D-uality/FusionZero-Robocup-International/4_documents/Datasheets/PDI 6221MG 360° 20KG 360° htm_files/1e6f4d21ef166d6ba756423e17e3e07e.png

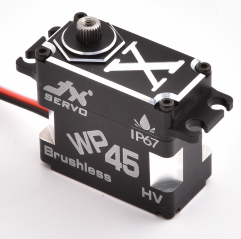
4_documents/Datasheets/PDI 6221MG 360° 20KG 360° htm_files/1e6f4d21ef166d6ba756423e17e3e07e.png
