D-uality/FusionZero-Robocup-International/4_documents/Datasheets/PDI 6221MG 360° 20KG 360° htm_files/1ec783de40fd63f22dcdefa5b233ecb2.png

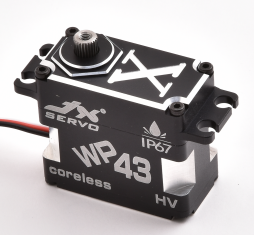
4_documents/Datasheets/PDI 6221MG 360° 20KG 360° htm_files/1ec783de40fd63f22dcdefa5b233ecb2.png
