D-uality/FusionZero-Robocup-International/4_documents/Datasheets/PDI 6221MG 360° 20KG 360° htm_files/089fc90d06dda99a380c83b12112168d.jpg

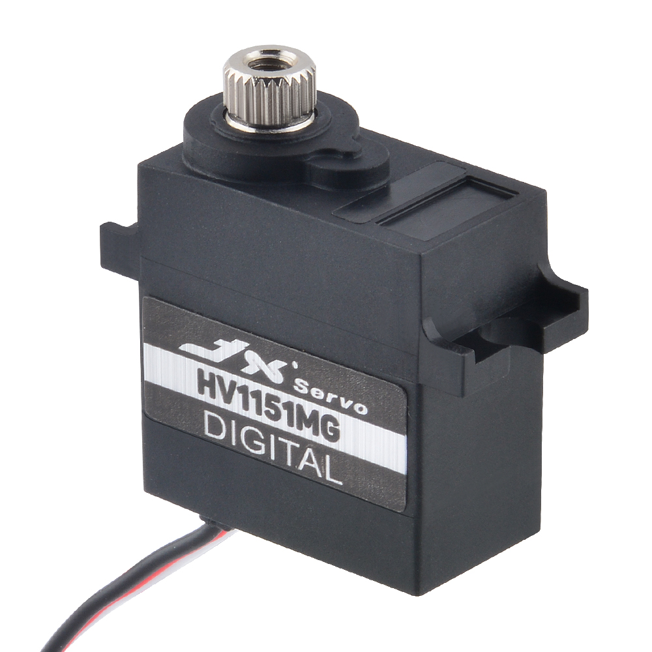
4_documents/Datasheets/PDI 6221MG 360° 20KG 360° htm_files/089fc90d06dda99a380c83b12112168d.jpg
