D-uality/FusionZero-Robocup-International/4_documents/Datasheets/PDI 6221MG 360° 20KG 360° htm_files/20177516175.png

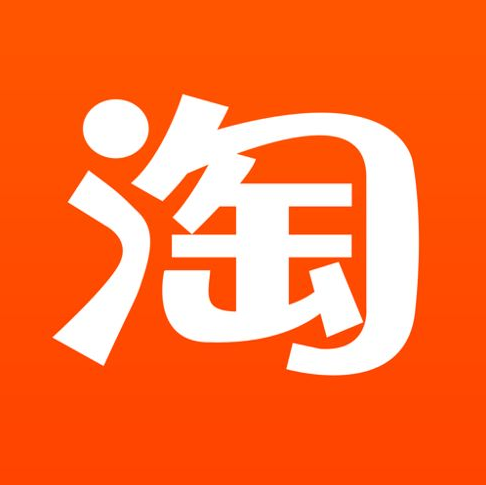
4_documents/Datasheets/PDI 6221MG 360° 20KG 360° htm_files/20177516175.png
