D-uality/FusionZero-Robocup-International/3_designs/back_base/Battery Base.step

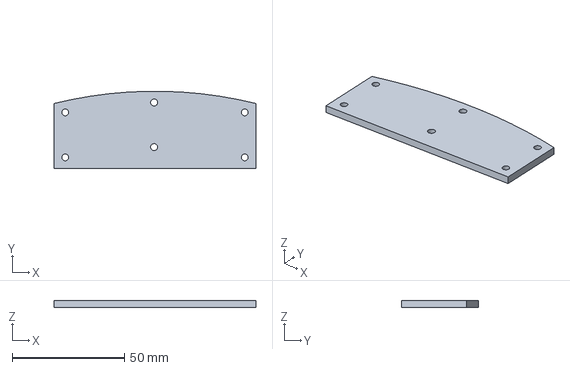
[picture p13: CAD file, 2025-03-10]
3_designs/back_base/Battery Base.step
89.8 x 34.4 x 3.00 mm
