D-uality/FusionZero-Robocup-International/3_designs/bottom_base/Bottom Base.step

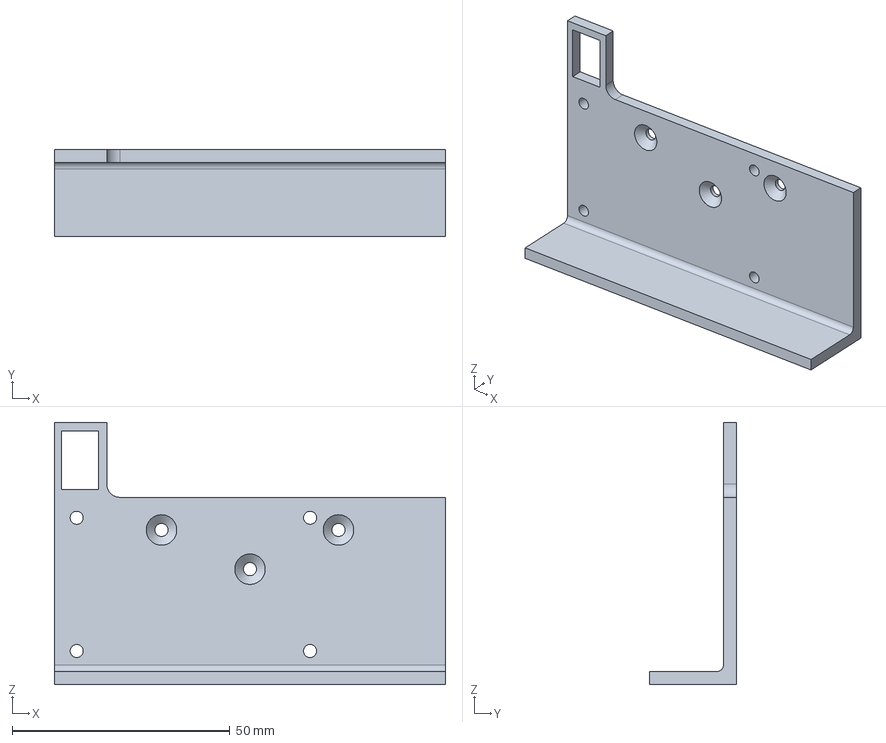
[picture p14: CAD file, 2025-03-10]
3_designs/bottom_base/Bottom Base.step
89.8 x 20.0 x 60.2 mm
