D-uality/FusionZero-Robocup-International/3_designs/components/TOF400C.step

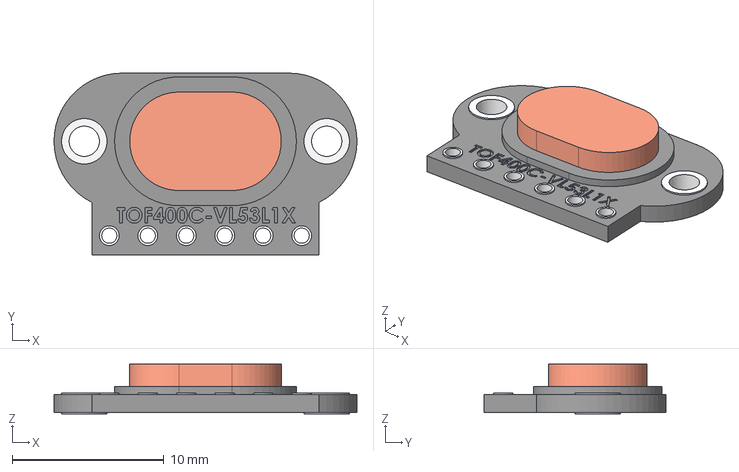
[picture p15: CAD file, 2025-03-10]
3_designs/components/TOF400C.step
20.0 x 12.0 x 3.30 mm
