D-uality/FusionZero-Robocup-International/3_designs/front_base/claw/Claw - [R] Support.step

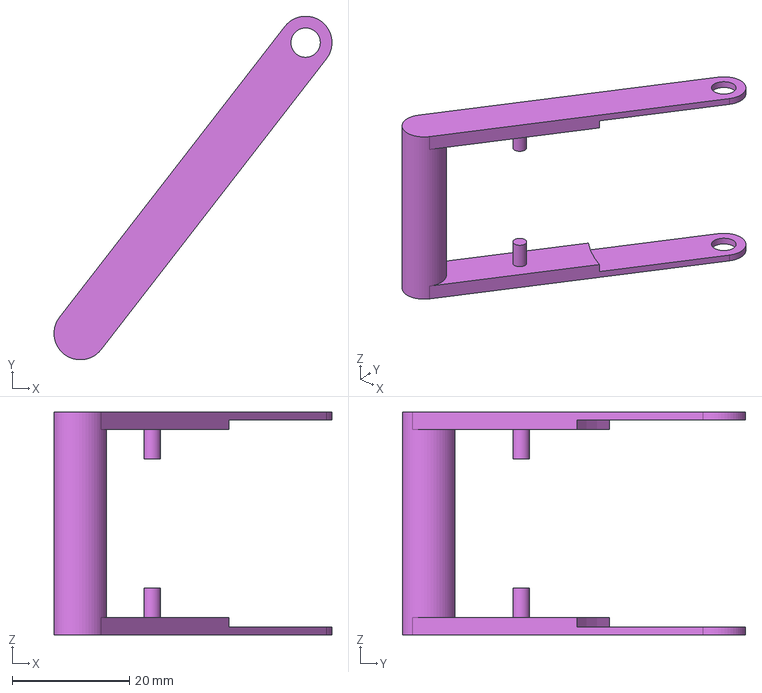
[picture p16: CAD file, 2025-03-10]
3_designs/front_base/claw/Claw - [R] Support.step
47.4 x 58.5 x 38.0 mm
