D-uality/FusionZero-Robocup-International/3_designs/front_base/Front Base.step

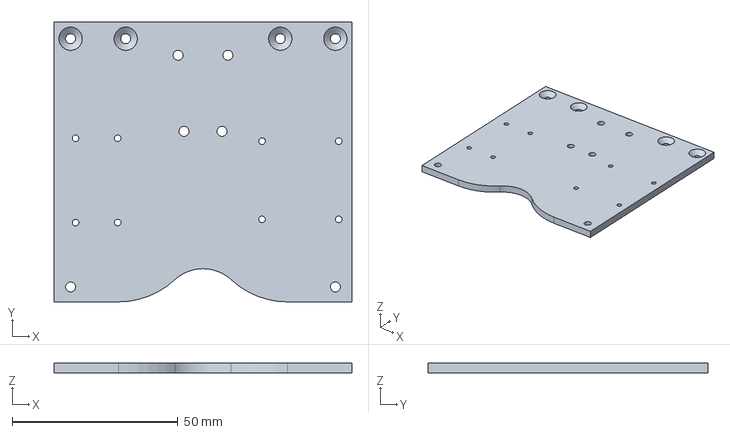
[picture p17: CAD file, 2025-03-10]
3_designs/front_base/Front Base.step
89.8 x 84.3 x 3.00 mm
