D-uality/FusionZero-Robocup-International/3_designs/front_base/lower_parts_frame/Front Touch Plate.step

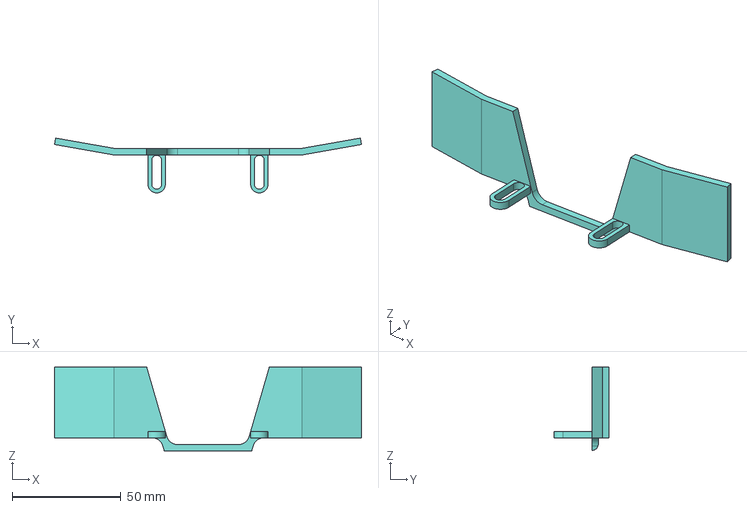
[picture p18: CAD file, 2025-03-10]
3_designs/front_base/lower_parts_frame/Front Touch Plate.step
140.8 x 25.2 x 38.3 mm
