D-uality/FusionZero-Robocup-International/3_designs/handle/Handle.step

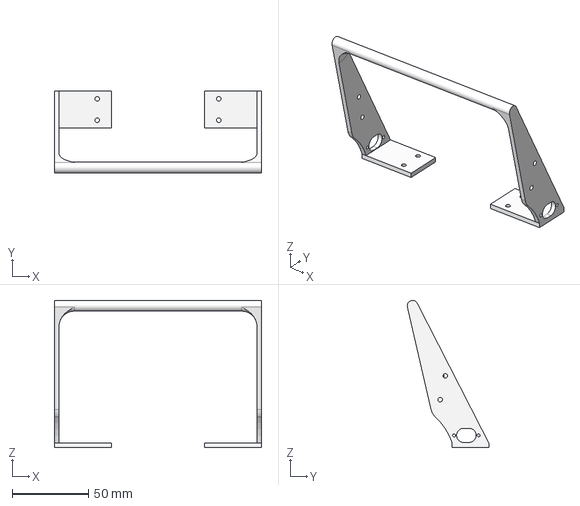
[picture p19: CAD file, 2025-03-10]
3_designs/handle/Handle.step
135.8 x 53.5 x 96.5 mm
