D-uality/FusionZero-Robocup-International/3_designs/handle/tilt_holder/Tilt Holder.step

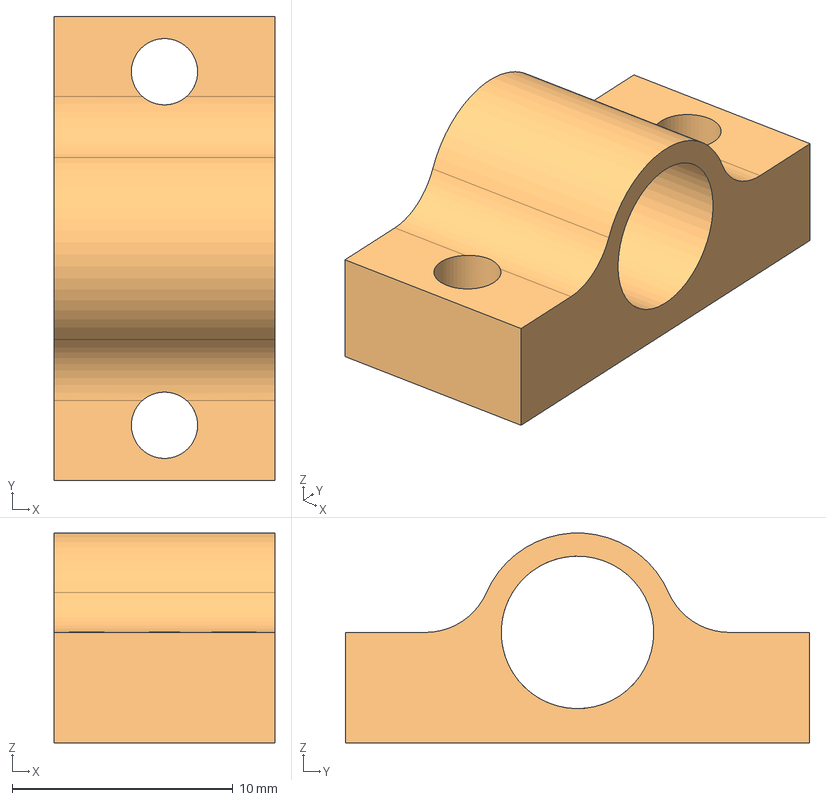
[picture p20: CAD file, 2025-03-10]
3_designs/handle/tilt_holder/Tilt Holder.step
10.0 x 21.0 x 9.49 mm
