D-uality/FusionZero-Robocup-International/3_designs/ir_sensors/IR Sensor Frame.step

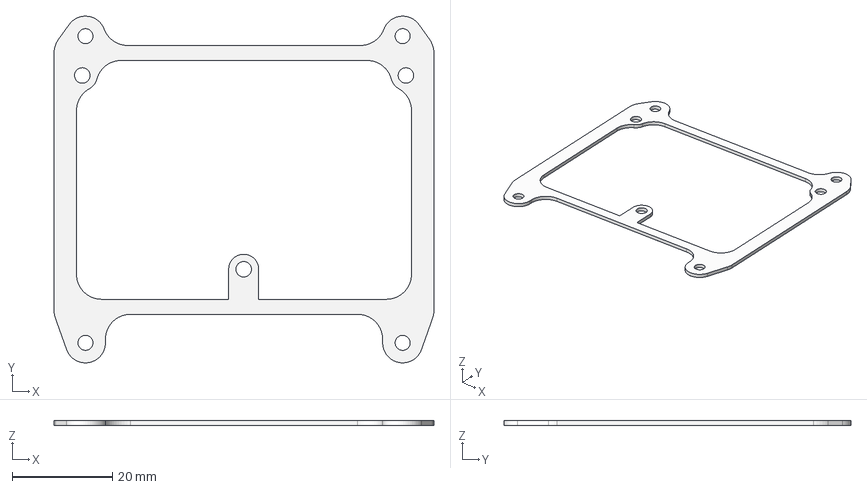
[picture p21: CAD file, 2025-03-10]
3_designs/ir_sensors/IR Sensor Frame.step
76.0 x 69.3 x 1 mm
