D-uality/FusionZero-Robocup-International/3_designs/servos/Servo Base.step

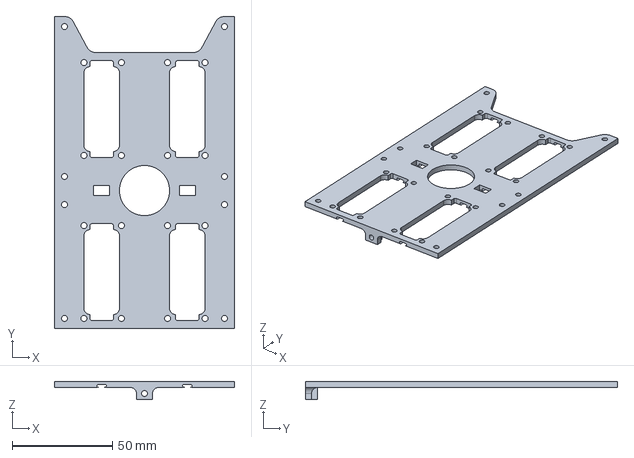
[picture p22: CAD file, 2025-03-10]
3_designs/servos/Servo Base.step
89.8 x 155.6 x 9.00 mm
