D-uality/FusionZero-Robocup-International/3_designs/back_base/Back Base.step

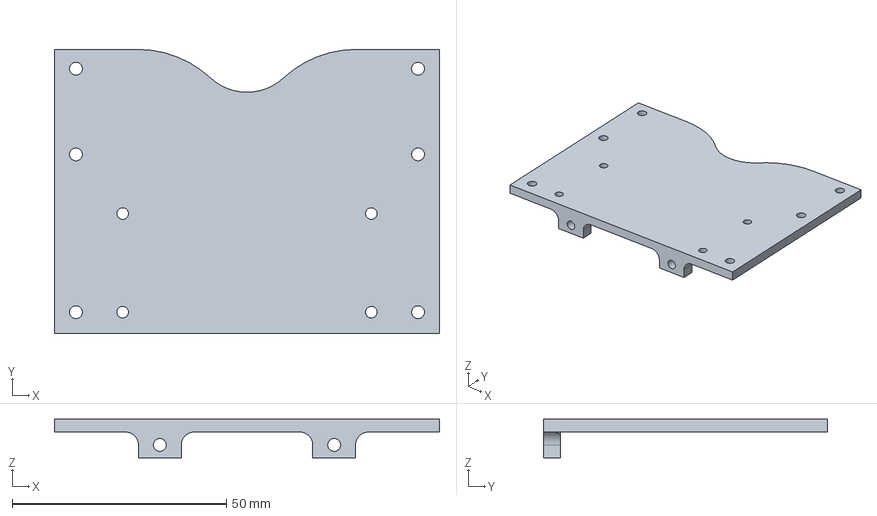
[picture p23: CAD file, 2025-03-10]
3_designs/back_base/Back Base.step
89.8 x 66.3 x 9.00 mm
