D-uality/FusionZero-Robocup-International/3_designs/components/Back Wheg - Back Wheg.step

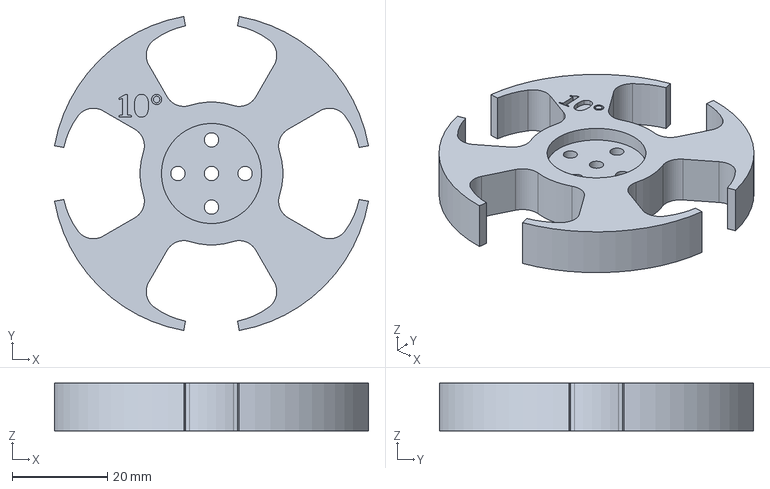
[picture p24: CAD file, 2025-03-10]
3_designs/components/Back Wheg - Back Wheg.step
65.9 x 65.9 x 10.0 mm
