D-uality/FusionZero-Robocup-International/3_designs/front_base/BNOO8X Frame.step

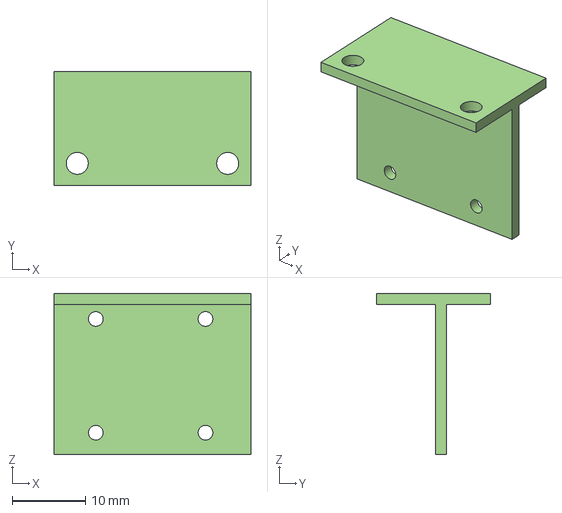
[picture p25: CAD file, 2025-03-10]
3_designs/front_base/BNOO8X Frame.step
26.8 x 15.5 x 22.0 mm
