D-uality/FusionZero-Robocup-International/3_designs/front_base/claw/Claw - Spiral Bevel 1M 15T 32deg.step

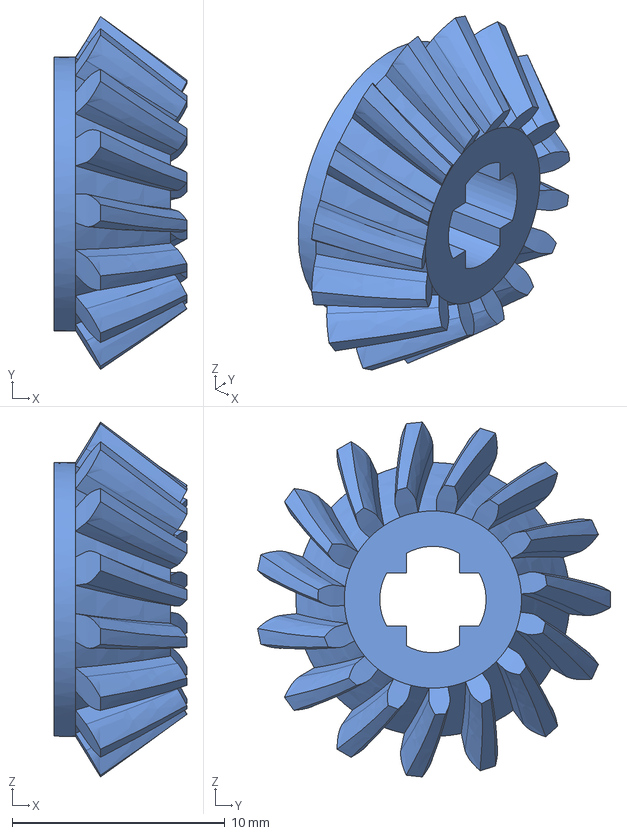
[picture p26: CAD file, 2025-03-10]
3_designs/front_base/claw/Claw - Spiral Bevel 1M 15T 32deg.step
6.23 x 16.6 x 16.7 mm
