D-uality/FusionZero-Robocup-International/3_designs/front_base/lower_parts_frame/Lower Parts Frame.step

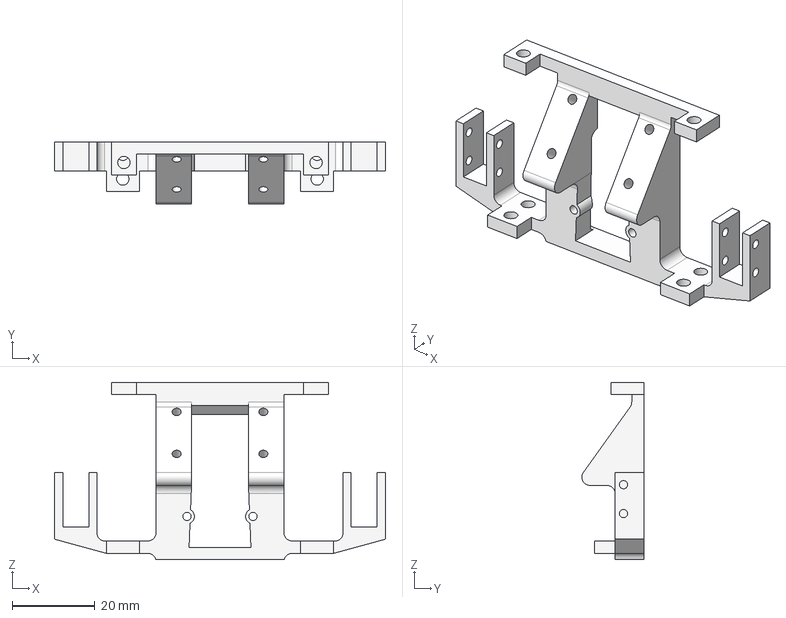
[picture p27: CAD file, 2025-03-10]
3_designs/front_base/lower_parts_frame/Lower Parts Frame.step
80.2 x 15.1 x 43.0 mm
