D-uality/FusionZero-Robocup-International/3_designs/servos/Servo Frame.step

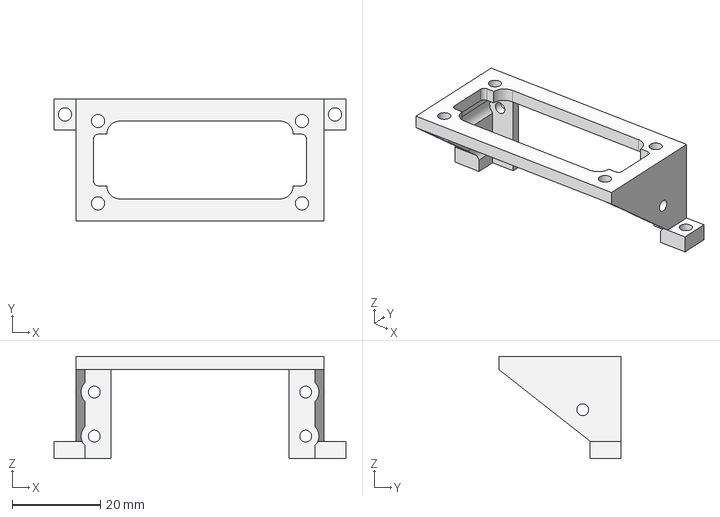
[picture p28: CAD file, 2025-03-10]
3_designs/servos/Servo Frame.step
66.3 x 27.7 x 23.2 mm
