D-uality/FusionZero-Robocup-International/3_designs/components/OLED 128x64 0.96.step

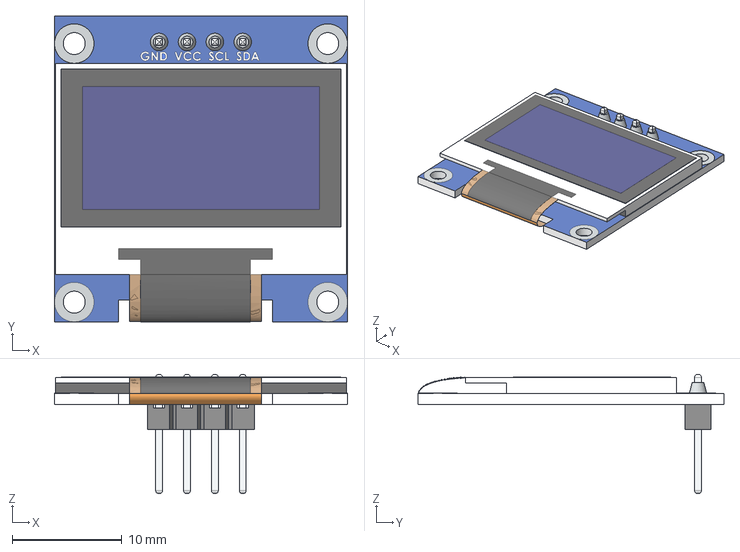
[picture p29: CAD file, 2025-03-10]
3_designs/components/OLED 128x64 0.96.step
26.7 x 27.9 x 10.8 mm
