D-uality/FusionZero-Robocup-International/3_designs/front_base/claw/Claw - [R] Claw.step

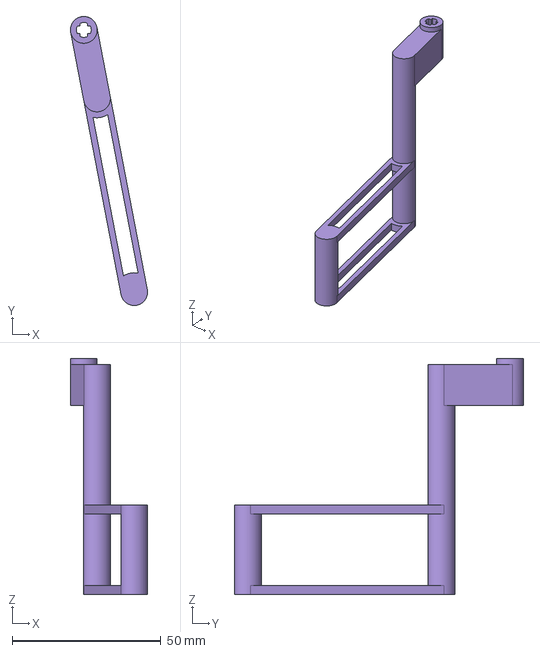
[picture p30: CAD file, 2025-03-10]
3_designs/front_base/claw/Claw - [R] Claw.step
25.9 x 97.0 x 79.3 mm
