D-uality/FusionZero-Robocup-International/3_designs/components/PDI_6221MG.STEP

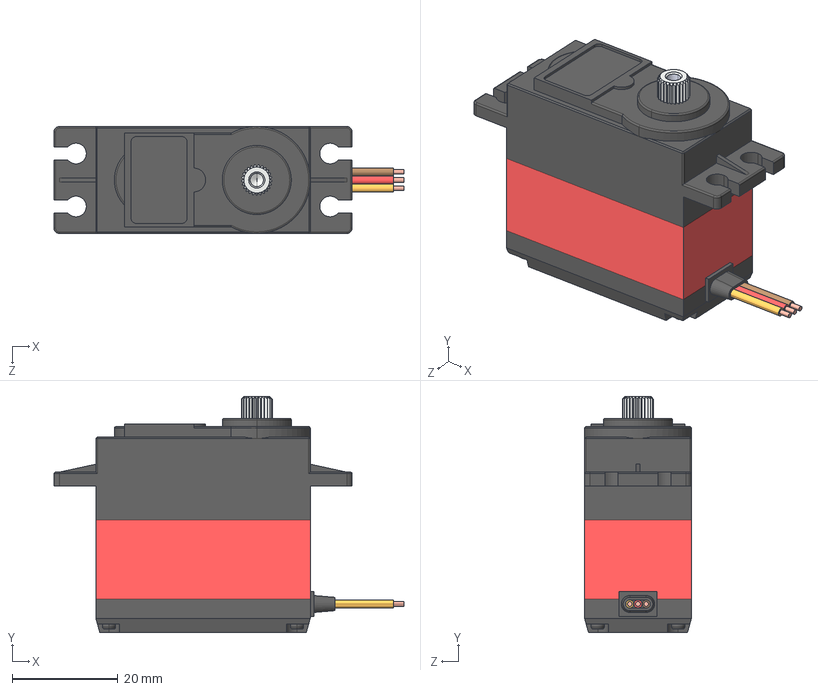
[picture p32: CAD file, 2025-03-10]
3_designs/components/PDI_6221MG.STEP
66.1 x 44.6 x 20.2 mm
