D-uality/FusionZero-Robocup-International/3_designs/components/Rocker Switch.stp

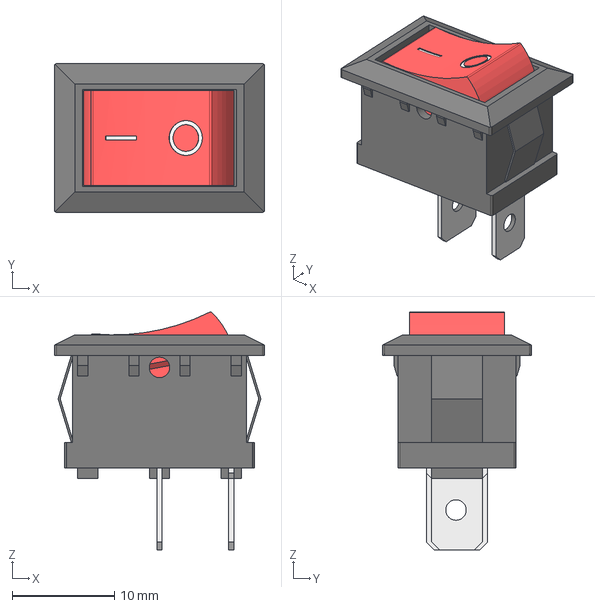
[picture p33: CAD file, 2025-03-10]
3_designs/components/Rocker Switch.stp
20.5 x 14.5 x 23.2 mm
