D-uality/FusionZero-Robocup-International/3_designs/front_base/claw/Claw - Spiral Bevel 1M 24T 58deg.step

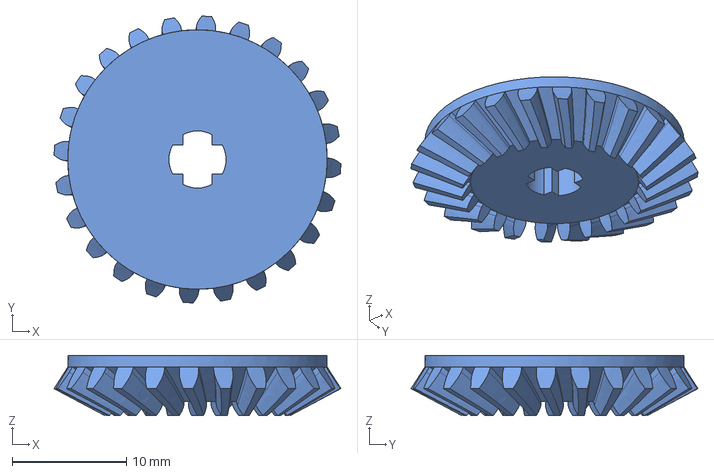
[picture p34: CAD file, 2025-03-10]
3_designs/front_base/claw/Claw - Spiral Bevel 1M 24T 58deg.step
25.1 x 25.1 x 5.26 mm
