D-uality/FusionZero-Robocup-International/3_designs/components/Rasbperry Pi Camera Module 3.step

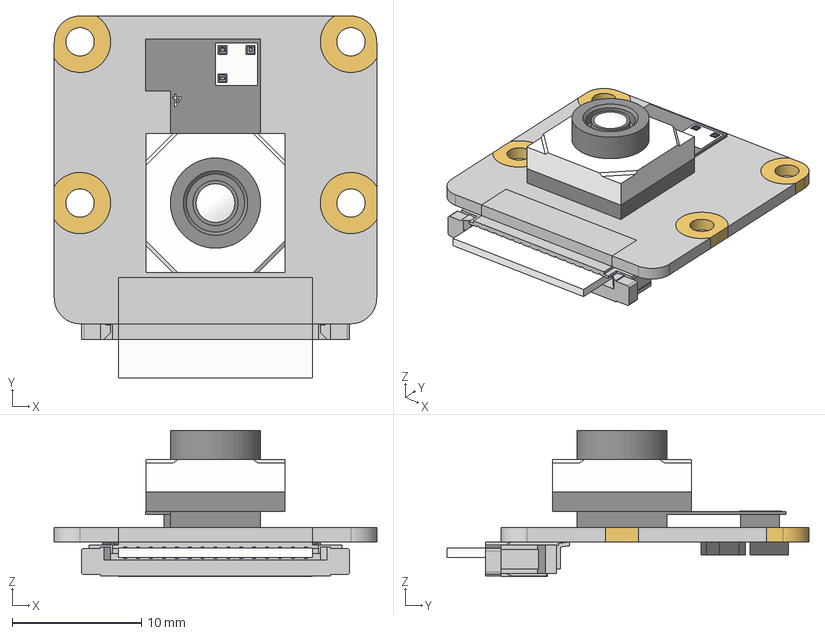
[picture p35: CAD file, 2025-03-10]
3_designs/components/Rasbperry Pi Camera Module 3.step
25.0 x 28.1 x 11.3 mm
Board
sfw15r3ste1lf
Sensor
Lens
Ring
Mount
Housing
