D-uality/FusionZero-Robocup-International/3_designs/components/Front Wheg - Front Wheg.step

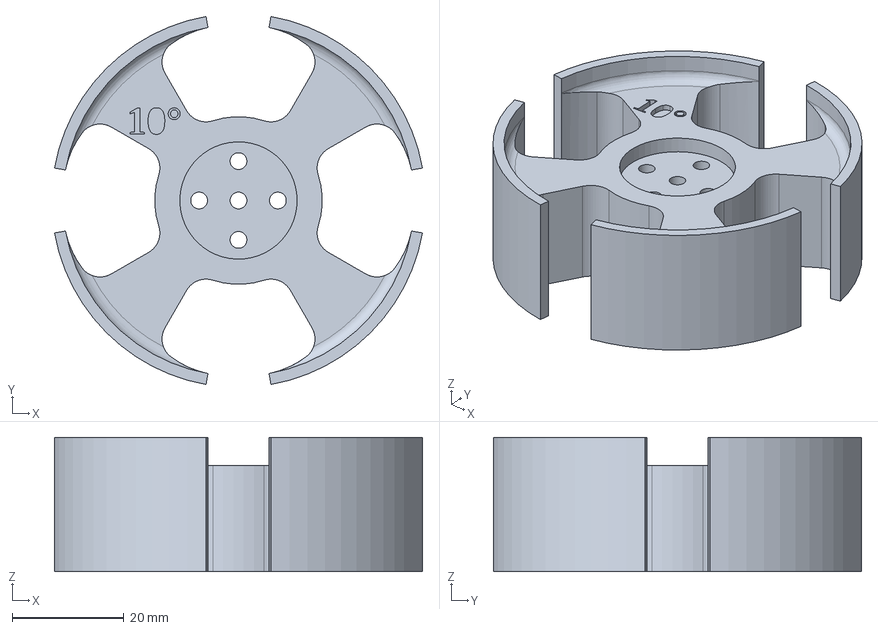
[picture p36: CAD file, 2025-03-10]
3_designs/components/Front Wheg - Front Wheg.step
65.9 x 65.9 x 24.0 mm
