D-uality/FusionZero-Robocup-International/3_designs/components/2 x 18650 Battery Holder.stp

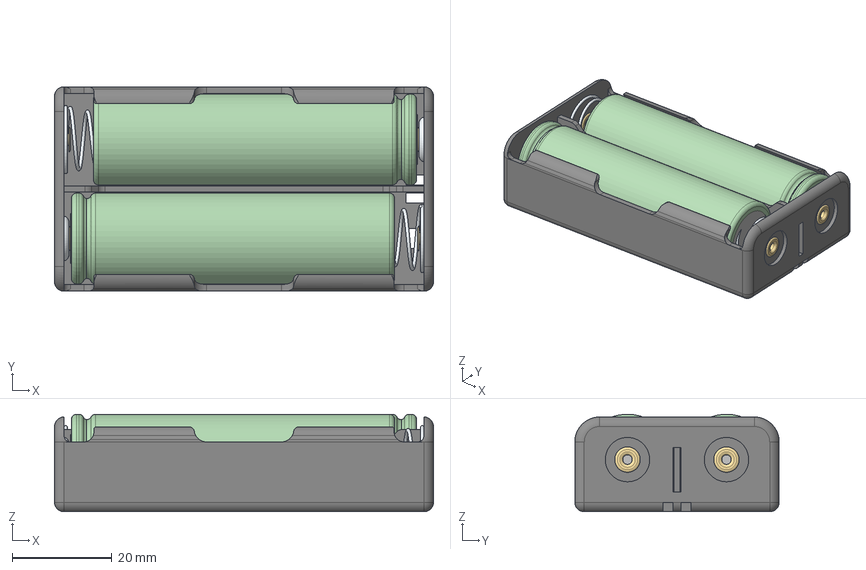
[picture p37: CAD file, 2025-03-10]
3_designs/components/2 x 18650 Battery Holder.stp
76.0 x 41.0 x 19.5 mm
Porta baterias 2x18650
Contacto_Helice_v2.0 x 2
Contacto_plano_v1.0 x 2
Bateria 18650 x 2
remache_v1.0 x 4
