D-uality/FusionZero-Robocup-International/3_designs/front_base/claw/Claw - Rotating Frame.step

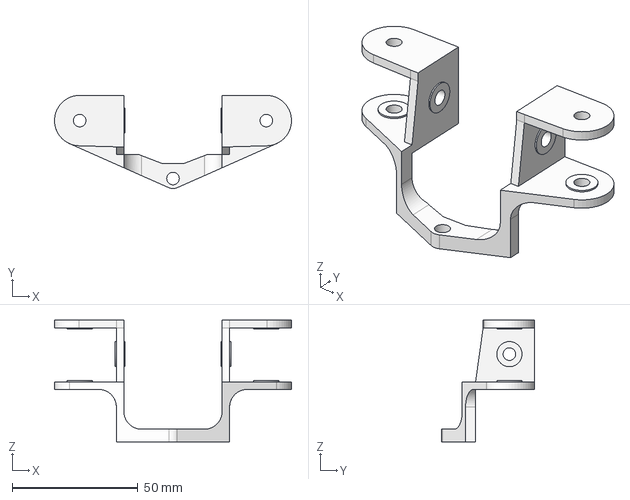
[picture p38: CAD file, 2025-03-10]
3_designs/front_base/claw/Claw - Rotating Frame.step
94.1 x 37.0 x 48.3 mm
