D-uality/FusionZero-Robocup-International/3_designs/components/Claw Servo.step

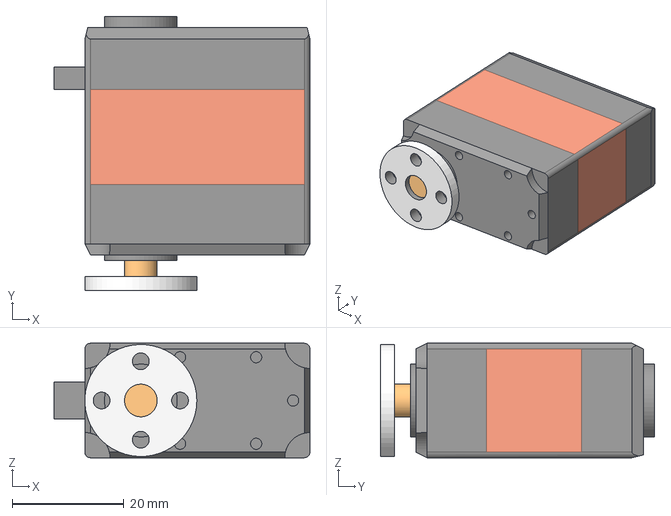
[picture p39: CAD file, 2025-03-10]
3_designs/components/Claw Servo.step
45.7 x 48.9 x 20.4 mm
