D-uality/FusionZero-Robocup-International/3_designs/front_base/claw/Claw - Drive Servo Frame.step

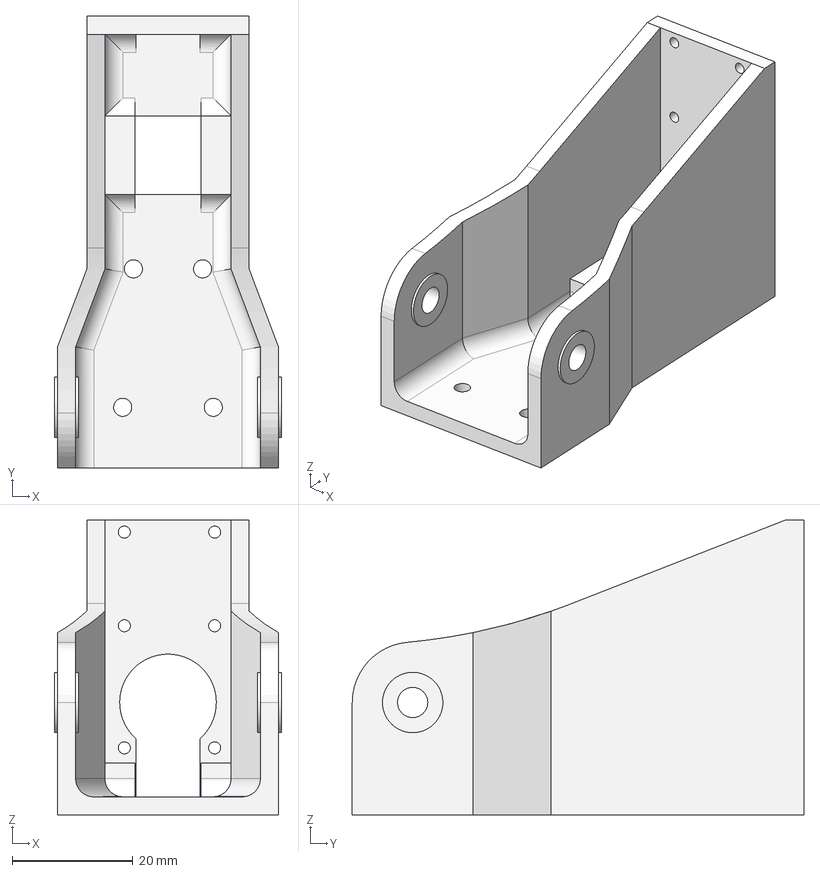
[picture p40: CAD file, 2025-03-10]
3_designs/front_base/claw/Claw - Drive Servo Frame.step
37.6 x 74.7 x 48.8 mm
