D-uality/FusionZero-Robocup-International/3_designs/components/Touch Sensor v1.step

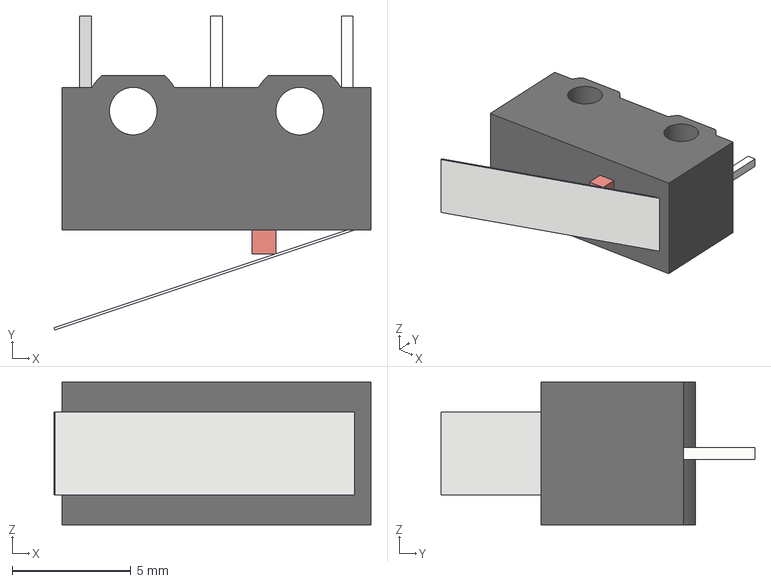
[picture p41: CAD file, 2025-03-10]
3_designs/components/Touch Sensor v1.step
13.3 x 13.2 x 6.00 mm
