D-uality/FusionZero-Robocup-International/3_designs/front_base/claw/Claw - Spiral Bevel 1M 25T 45deg.step

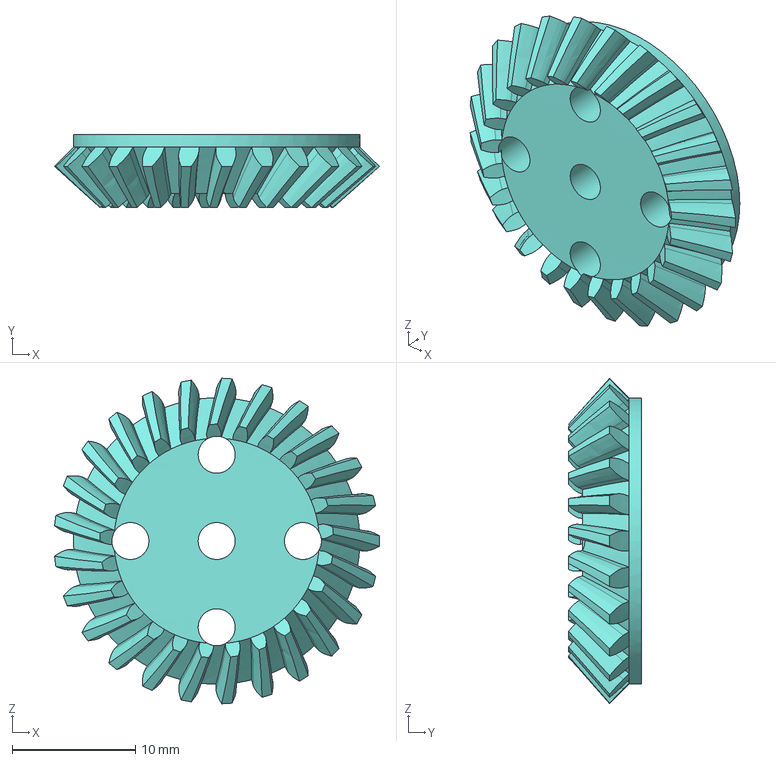
[picture p42: CAD file, 2025-03-10]
3_designs/front_base/claw/Claw - Spiral Bevel 1M 25T 45deg.step
26.4 x 5.92 x 26.4 mm
