D-uality/FusionZero-Robocup-International/(list of files, cad)

Other CAD files:
3_designs/front_base/claw/Claw - [L] Claw.step
3_designs/front_base/claw/Claw - [L] Support.step
3_designs/front_base/claw/Claw - Spiral Bevel 1M 15T 32deg (1).step
3_designs/front_base/claw/Claw - Spiral Bevel 1M 24T 58deg (1).step
3_designs/front_base/claw/Claw - Spiral Bevel 1M 25T 45deg (1).step
3_designs/front_base/claw/Claw - Spiral Bevel 1M 25T 45deg (2).step
