D-uality/FusionZero-Robocup-International/2_pre_internatinal/calibration/calibration_values.txt

7.10 9.03 13.09 22.48 63.92 -56.28 -21.35 -12.75 -8.91 -6.70 
6.20 7.94 10.47 16.92 40.13 -55.05 -19.02 -11.42 -8.26 -6.29 
5.09 6.59 9.15 15.34 50.86 -47.73 -15.12 -9.03 -8.37 -6.10 
5.44 6.79 9.61 15.71 44.90 -50.69 -16.37 -9.78 -7.00 -5.43
