D-uality/FusionZero-Robocup-International/2_pre_internatinal/calibration/frederick_calibration_values.txt

4.68 6.06 8.71 15.39 64.80 40.01 12.82 7.54 5.55 4.59
4.97 5.86 8.33 14.46 47.65 67.51 14.04 8.03 5.51 4.56
4.91 5.96 8.39 14.33 47.99 39.45 13.11 8.05 5.84 4.89
4.88 5.77 8.28 14.11 46.50 45.11 13.10 7.96 5.76 4.85
