D-uality/FusionZero-Robocup-International/2_pre_internatinal/pre_international/evacuation_zone/calibration_values.txt

23,25,35,27,23,119,115
163,164,163,181,185,206,214
