D-uality/FusionZero-Robocup-International/2_pre_internatinal/pre_international/line_follow/colour_line_following/calibration_values.txt

44,44,72,55,58,167,154
207,208,221,148,196,227,226
