D-uality/FusionZero-Robocup-International/2_pre_internatinal/pre_international/competition_mode/robocup_japan_open/modules/calibration_values.txt

39,42,40,39,29,102,89
167,163,153,151,150,190,181
