D-uality/FusionZero-Robocup-International/2_pre_internatinal/pre_international/competition_mode/robocup_singapore_open/modules/calibration_values.txt

25,27,25,19,17,98,78
184,178,168,166,164,193,177
