D-uality/FusionZero-Robocup-International/2_pre_internatinal/pre_international/line_follow/sensor_fusion_line_following/2_gyro_integration/modules/calibration_values.txt

27,31,35,24,16,89,67
187,182,177,167,164,171,156
