D-uality/FusionZero-Robocup-International/2_pre_internatinal/pre_international/line_follow/sensor_fusion_line_following/1_line_follow_testing/modules/calibration_values.txt

45,54,0,50,36,143,143
196,192,196,213,208,211,219
