D-uality/FusionZero-Robocup-International/2_pre_internatinal/pre_international/evacuation_zone/4_exit/config.py

WIDTH, HEIGHT, FLIP = 320, 240, False
SCREEN_WIDTH, SCREEN_HEIGHT = 128, 64
X11 = True

touch_pins = [5, 6, 22, 26]  # FL, FR, BL, BR
x_shut_pins = [23, 24, 25]  # Left, Middle, Right

stop_angles = [88, 89, 88, 89]
servo_pins = [14, 13, 12, 10]  # FL, FR, BL, BR
claw_pin = 9

# ------------------------------------------

status_messages = []

victim_count = 2
evacuation_speed = 35
approach_distance = 18

def update_log(data: list[str], coloumn_widths: list[int], separator: str = "|") -> str:
    formatted_cells = [f"{cell:^{width}}" for cell, width in zip(data, coloumn_widths)]
    return f" {separator} ".join(formatted_cells)
