D-uality/FusionZero-Robocup-International/2_pre_internatinal/pre_international/evacuation_zone/2_spectral_highlight/motors.py

from config import *
import time
from adafruit_servokit import ServoKit
import operator

pca = ServoKit(channels=16)
pca.servo[claw_pin].actuation_range = 270

def initialise():
    try:
        pca.servo[servo_pins[0]].angle = stop_angles[0]
        pca.servo[servo_pins[1]].angle = stop_angles[1]
        pca.servo[servo_pins[2]].angle = stop_angles[2]
        pca.servo[servo_pins[3]].angle = stop_angles[3]

        pca.servo[claw_pin].angle = 270
    except Exception as e:
        print(f"Failed to initialise motors: {e}")

def run(v1, v2, delay=0):

    calculatedAngles = [0, 0, 0, 0]

    negativeGradients  = [0.69106, 0.73440, 0.68426, 0.67425]
    negativeIntercepts = [-6.8834, -4.9707, -5.0095, -4.9465]
    positiveGradients  = [0.69924, 0.66035, 0.69858, 0.67916]
    positiveIntercepts = [4.1509, 6.5548, 3.5948, 4.2287]
    
    for i in range(0, 2):
        if   (v1 < negativeIntercepts[i]): calculatedAngles[i] = negativeGradients[i] * v1 + negativeIntercepts[i];
        elif (v1 > positiveIntercepts[i]): calculatedAngles[i] = positiveGradients[i] * v1 + positiveIntercepts[i];
        else:                              calculatedAngles[i] = 0;

        calculatedAngles[i] = max(min(calculatedAngles[i], 90), -90)

    v2 = v2 * -1

    for i in range(2, 4):
        if   (v2 < negativeIntercepts[i]): calculatedAngles[i] = negativeGradients[i] * v2 + negativeIntercepts[i];
        elif (v2 > positiveIntercepts[i]): calculatedAngles[i] = positiveGradients[i] * v2 + positiveIntercepts[i];
        else:                              calculatedAngles[i] = 0;

        calculatedAngles[i] = max(min(calculatedAngles[i], 90), -90)

    pca.servo[servo_pins[0]].angle = stop_angles[0] + calculatedAngles[0]
    pca.servo[servo_pins[1]].angle = stop_angles[1] + calculatedAngles[1]
    pca.servo[servo_pins[2]].angle = stop_angles[2] + calculatedAngles[2]
    pca.servo[servo_pins[3]].angle = stop_angles[3] + calculatedAngles[3]

    if delay > 0:
        time.sleep(delay)

        pca.servo[servo_pins[0]].angle = stop_angles[0]
        pca.servo[servo_pins[1]].angle = stop_angles[1]
        pca.servo[servo_pins[2]].angle = stop_angles[2]
        pca.servo[servo_pins[3]].angle = stop_angles[3]

def run_until(v1, v2, trigger_function, index, comparison, target_value, text=""):
    if   comparison == "==": comparison_function = operator.eq
    elif comparison == "<=": comparison_function = operator.le
    elif comparison == ">=": comparison_function = operator.ge
    elif comparison == "!=": comparison_function = operator.ne

    value = trigger_function()[index]
    while not comparison_function(value, target_value) and value is not None:
        value = trigger_function()[index]
        run(v1, v2)
        print(f"({text})")

    run(0, 0)

def claw_step(target_angle, time_delay):
    if target_angle == 270: target_angle = 269
    if target_angle == 0:   target_angle = 1
    current_angle = pca.servo[claw_pin].angle
    
    if current_angle == target_angle:
        return
    
    elif current_angle > target_angle:
        while current_angle > target_angle:
            current_angle -= 1
            pca.servo[claw_pin].angle = current_angle
            time.sleep(time_delay)
    
    else:
        while current_angle < target_angle:
            current_angle += 1
            pca.servo[claw_pin].angle = current_angle
            time.sleep(time_delay)
