D-uality/FusionZero-Robocup-International/2_pre_internatinal/pre_international/evacuation_zone/2_spectral_highlight/config.py

WIDTH, HEIGHT, FLIP = 320, 240, False
SCREEN_WIDTH, SCREEN_HEIGHT = 128, 64
X11 = True

touch_pins  = [6, 5, 22, 26]
x_shut_pins = [24, 25, 12]

stop_angles = [89, 88, 89, 88]
servo_pins = [14, 13, 12, 10]
claw_pin = 9
