D-uality/FusionZero-Robocup-International/6_technical_challenege/behaviours/robot_state.py

class RobotState():
    def __init__(self):
        # Constants
        self.debug = True
        self.timings = False

        # Variables
        self.debug_text = []
        self.oled_put_text = None
        
        self.count = {
            "uphill": 0,
            "downhill": 0,
            "tilt_left": 0,
            "tilt_right": 0,
            "red": 0,
            "silver": 0,
            "touch": 0
        }
         
        self.trigger = {
            "uphill": False,
            "downhill": False,
            "tilt_left": False,
            "tilt_right": False,
            "seasaw": False,
            "evacuation_zone": False
        }
        
        self.last_downhill = self.last_uphill = 10000
        self.last_seen_silver = self.silver_count = self.main_loop_count = 0
        self.time_since_downhill = 0
        self.prev_downhill = False
        self.first_red = False
        self.red_timer = 0
        # self.blank_for_next_red = False
        
    def reset(self):
        # Constants
        self.debug = True
        self.timings = False

        # Variables
        self.debug_text = []
        self.oled_put_text = None
        
        self.count = {
            "uphill": 0,
            "downhill": 0,
            "tilt_left": 0,
            "tilt_right": 0,
            "red": 0,
            "silver": 0,
            "touch": 0
        }
        
        self.trigger["uphill"] = False
        self.trigger["downhill"] = False
        self.trigger["tilt_left"] = False
        self.trigger["tilt_right"] = False
        self.trigger["seasaw"] = False
        
        self.last_downhill = self.last_uphill = 10000
        self.last_seen_silver = self.silver_count = self.main_loop_count = 0
        self.time_since_downhill = 0
        self.prev_downhill = False
        self.first_red = False
        self.red_timer = 0
        # self.blank_for_next_red = False
        
