D-uality/FusionZero-Robocup-International/2_pre_internatinal/pre_international/competition_mode/robocup_japan_open/main.py

import os
import sys
import time
from listener import listener

current_dir = os.path.dirname(os.path.abspath(__file__))
modules_dir = os.path.abspath(os.path.join(current_dir, 'modules'))

if modules_dir not in sys.path: sys.path.insert(0, modules_dir)

import camera
# import colour
# import laser_sensors
# import touch_sensors
# import oled_display
import motors
# import gyroscope
import led
import line
import evacuation_zone
import testing
import config

def main() -> None:
    start_time = time.time()
    # oled_display.initialise()
    # laser_sensors.initialise()
    # touch_sensors.initialise()
    motors.initialise()
    camera.initialise("line")
    # gyroscope.initialise()
    
    motors.run(0, 0)
    # oled_display.reset()
    led.off()
    
    config.update_log(["INITIALISATION", f"({time.time() - start_time:.2f})"], [24, 15])
    print()
    
    try:
        while not listener.has_exited():
            mode = listener.get_mode()
            
            if mode == 0:
                motors.run(0, 0)
                led.off()

            elif mode == 1:
                line.main()
                
            elif mode == 2:
                evacuation_zone.main()
            
            elif mode == 4:
                config.update_log(["READING SENSORS", ", ".join(list(map(str, colour.read()))), ", ".join(list(map(str, touch_sensors.read()))), ", ".join(list(map(str, laser_sensors.read())))], [24, 30, 10, 20])
                print()

            elif mode == 5:
                colour.calibration(auto_calibrate=False)
                colour.load_calibration_values()
                listener.mode = 0

            elif mode == 6:
                testing.run_input()
            
            elif mode == 9: listener.exit_event.set()

    finally:
        camera.close()
        # oled_display.reset()
        motors.run(0, 0)
    
if __name__ == "__main__": main()
