D-uality/FusionZero-Robocup-International/2_pre_internatinal/pre_international/evacuation_zone/2_spectral_highlight/main.py

import time
start_time = time.time()
import cv2
import numpy as np
from random import randint

from config import *
import gpio
import laser_sensors
import touch_sensors
import oled_display
import camera
import motors
import evacuation_zone
import live_victims
import dead_victims
import triangles

try:
    gpio.initialise()
    oled_display.initialise()
    laser_sensors.initialise()
    touch_sensors.initialise()
    camera.initialise()
    motors.initialise()

    input(f"({time.time() - start_time:.2f}) Press enter to begin program! ")
    oled_display.reset()

    display_found = False
    display_reset = False
    target_distance = 18
    base_speed = 30

    while True:
        motors.claw_step(270, 0)
        # evacuation_zone.find_live(base_speed=base_speed)

        # if live_victims.route(base_speed=base_speed, kP=0.08, target_distance=target_distance):
        #     if live_victims.align(base_speed=base_speed, target_distance=target_distance):
        #         if evacuation_zone.grab(base_speed=base_speed):
        #             triangles.find(base_speed=base_speed)
        #             evacuation_zone.dump(base_speed=base_speed)
                    
        #     else: motors.run(base_speed, -base_speed, 0.8)

        evacuation_zone.find(base_speed=base_speed, search_function=dead_victims.find)

        input()

except KeyboardInterrupt:
    print("Exiting Gracefully")

finally:
    gpio.cleanup()
    oled_display.reset()
    camera.close()
    motors.run(0, 0)
    motors.claw_step(270, 0)
