D-uality/FusionZero-Robocup-International/2_pre_internatinal/pre_international/evacuation_zone/3_dead_victims/main.py

import time
start_time = time.time()

import config
import gpio
import laser_sensors
import touch_sensors
import oled_display
import camera
import motors
import evacuation_zone
import victims
import triangles
from tabulate import tabulate

try:
    gpio.initialise()
    oled_display.initialise()
    laser_sensors.initialise()
    touch_sensors.initialise()
    camera.initialise()
    motors.initialise()

    input(f"({time.time() - start_time:.2f}) Press enter to begin program! ")
    oled_display.reset()

    while True:
        if config.victim_count == 3: break
        search_type = victims.live if config.victim_count < 2 else victims.dead
        motors.claw_step(270, 0)

        evacuation_zone.find(search_function=search_type)

        if evacuation_zone.route(search_function=search_type, kP=0.12):
            if evacuation_zone.align(search_function=search_type, step_time=0.01):
                if evacuation_zone.grab():
                    motors.claw_step(180, 0.005)
                    triangles.find()
                    evacuation_zone.dump()
                    config.victim_count += 1
                else:
                    motors.claw_step(0, 0)
                    motors.run(-config.evacuation_speed, -config.evacuation_speed, 0.8)
            else: motors.run(-config.evacuation_speed, -config.evacuation_speed, 0.8)

    print("EVAC FINISHED")

except KeyboardInterrupt:
    print("Exiting Gracefully")

finally:
    gpio.cleanup()
    oled_display.reset()
    camera.close()
    motors.run(0, 0)
    motors.claw_step(270, 0)
