D-uality/FusionZero-Robocup-International/2_pre_internatinal/pre_international/evacuation_zone/2_spectral_highlight/touch_sensors.py

from config import *

import RPi.GPIO as GPIO
import oled_display

def initialise():
    try:
        for touch_pin in touch_pins:
            GPIO.setup(touch_pin, GPIO.IN, pull_up_down=GPIO.PUD_UP)

        print("Touch initialised!")
        oled_display.text("Touch: ✓", 0, 30)
        
    except Exception as e:
        print(f"Touch failed to initialise: {e}")
        oled_display.text("Touch: x", 0, 30)

def read(pins=touch_pins):
    values = []

    for pin in pins:
        values.append(GPIO.input(pin))

    print(f"Touch: {values}", end="    ")
    return values
