D-uality/FusionZero-Robocup-International/2_pre_internatinal/pre_international/competition_mode/robocup_japan_open/victims.py

import cv2
import numpy as np
from typing import Optional
# import laser_sensors

import config

def live(image: np.ndarray) -> Optional[int]:
    spectral_threshold = 200

    kernal_size = 7
    spectral_highlights = cv2.inRange(image, (spectral_threshold, spectral_threshold, spectral_threshold), (255, 255, 255))
    spectral_highlights = cv2.dilate(spectral_highlights, np.ones((kernal_size, kernal_size), np.uint8), iterations=1)

    contours, _ = cv2.findContours(spectral_highlights, cv2.RETR_EXTERNAL, cv2.CHAIN_APPROX_SIMPLE)

    if not contours: return None
    if config.X11: cv2.drawContours(image, contours, -1, (0, 0, 255), 1)

    valid_contours = []
    
    for contour in contours:
        _, y, w, h = cv2.boundingRect(contour)
        print(cv2.contourArea(contour))
        
        # look for contours in the top quarter
        if (y + h/2 < 50
            and cv2.contourArea(contour) < 700):
            valid_contours.append(contour)
    
    if len(valid_contours) == 0: return None

    largest_contour = max(valid_contours, key=cv2.contourArea)
    x, _, w, _ = cv2.boundingRect(largest_contour)
    
    if config.X11: cv2.drawContours(image, [largest_contour], -1, (0, 255, 0), 1)
    return int(x + w/2)

def dead(image: np.ndarray) -> Optional[int]:
    def circularity_check(contour: np.ndarray, threshold: float) -> bool:
        perimeter = cv2.arcLength(contour, True)
        area = cv2.contourArea(contour)

        if perimeter == 0: return False

        circularity = (4 * np.pi * area) / (perimeter ** 2)

        if circularity > threshold: return True
        return False
    
    hsv_image = cv2.cvtColor(image, cv2.COLOR_BGR2HSV)
    
    black_mask = cv2.inRange(hsv_image, (0, 0, 0), (179, 255, 30))
    contours, _ = cv2.findContours(black_mask, cv2.RETR_EXTERNAL, cv2.CHAIN_APPROX_SIMPLE)
    
    # If there are no contours, or there are many, return None
    if not contours or len(contours) > 5: return None
    
    if config.X11: cv2.drawContours(image, contours, -1, (0, 0, 255), 1)
    
    valid_contours = []
    
    for contour in contours:
        _, y, _, h = cv2.boundingRect(contour)
        if (y + h/2 < config.EVACUATION_HEIGHT / 2 + 30
            and circularity_check(contour, 0.5)
            and cv2.contourArea(contour) > 100
            and cv2.contourArea(contour) < 10000):
            valid_contours.append(contour)
    
    if len(valid_contours) == 0: return None
    
    largest_contour = max(valid_contours, key=cv2.contourArea)

    x, _, w, _ = cv2.boundingRect(largest_contour)
    
    if config.X11: cv2.drawContours(image, [largest_contour], -1, (0, 255, 0), 1)

    return int(x + w/2)
