D-uality/FusionZero-Robocup-International/2_pre_internatinal/pre_international/evacuation_zone/2_spectral_highlight/gpio.py

from config import *
import RPi.GPIO as GPIO

def initialise():
    try:
        GPIO.setmode(GPIO.BCM)
        print("GPIO initialised!")
        
    except Exception as e:
        pritn(f"GPIO failed to initialise: {e}")

def cleanup():
    GPIO.cleanup()
