D-uality/FusionZero-Robocup-International/(commit log)

2024-12-02 initial tests; - touch sensors don't work because of wiring? maybe a skill issue - servo's work fine - lasers work fine - using a python virtual environment to keep library versions clean
    [pyvenv.cfg]
2024-12-02 fixed the touch sensor tests - confusion with BCM and BOARD - switched from pull down to pull up
2024-12-03 started servo calibration
2024-12-03 did some more servo calibraition, generated data
2024-12-04 calibration generates equation: - no distinction between positive and negative - cannot display graphs
2024-12-05 Added line following code along with folders to hold the seperate versions, added Camera testing code I2C testing folder, matched naming conventions and improved servo testing code
2024-12-05 Finished servo calibration - linear ramp - equal servo speeds
2024-12-06 Added servo motor testing
2024-12-06 Found servo stop values
2024-12-06 Added specific stop angles for different servos.
2024-12-06 Changed U-Turn detection to increase reliability (instead of seeing left or right on U-Turns). Added stopping motors during Line-following functionality using cv2.waitKey for inputs.
2024-12-14 Added LED test code
2024-12-14 fixed some more motor calibration added more steps to validating the exit
    [config.py, laser_sensors.py, main.py, servo_calibration.py, servo_midpoint.py, servo_timer.py]
2024-12-14 changed led_on_off library from gpiozero to RPi.GPIO
2024-12-15 Added simple ads7830 colour sensor reading
2024-12-15 Fixed led code from GPIO.OUTPUT to OUT. Added led version of line following. Although, my attempts to fix the black line following on the difficult multiple 90 degree turos was not successful. Perhap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
    [Main.py, black.py, config.py, green.py, led.py, motor.py, transform.py]
2024-12-15 Using adafruit library for readin ads7830 with front right and middle right values stil coupling and affecting nearby/other analog inputs
2024-12-16 Fixed invalidate contour determining by ensuring that it pcisk the contour most similar to the previous frame.
    [Main.py, black.py, config.py, green.py, led.py, motor.py, transform.py]
2024-12-17 Fixed green validation, by changing check point based on gradient being negative or positive as it multiplies negative vectors causing the check points to check below green instead of above green. Al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
    [Main.py, black.py, config.py, green.py, led.py, motor.py, transform.py]
2024-12-18 laser alignement
2024-12-18 Attempted to recognize gaps for extended amount of time to confirm an evacuation zone entry. However silver appears similar to black. Thus for now we must skip this.
    [Main.py, black.py, config.py, green.py, led.py, motor.py, transform.py]
2024-12-18 Fixed camera not displaying. Now use cv2 commadns inside of XMing window to control the robot. Including WASD for motors, Space to stop, L for led, and q to exit.
2024-12-18 standardized console output, fixed spelling
    [camera.py, gpio.py, laser_sensors.py, main.py, oled_display.py, touch_sensors.py]
2024-12-18 Improved line following and green turns. However, double green detection has an issue with display or corrupting the display image. Framerate is also curcial to line following and green turn consiste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
    [Main.py, black.py, config.py, green.py, led.py, motor.py, transform.py]
2024-12-19 with new camera frame, more development. Added spectralhighlight, routing
2024-12-22 adjusted logic and flow, much easier to work with now
2024-12-27 fixed logic flow
2024-12-28 changing from log back to print
2024-12-28 fixing print -> more bugs
    [camera.py, config.py, laser_sensors.py, main.py, motors.py, touch_sensors.py, triangles.py]
2024-12-30 changed print to tabulate
2024-12-31 printing + logic fixed
    [camera.py, config.py, evacuation_zone.py, gpio.py, laser_sensors.py, main.py, motors.py, oled_display.py]
2025-01-03 Renamed Camera Line following folder.
2025-01-07 Moved cam line following sub folders into the right folder, created simple black line following code with auto calibration. Updated colour sensors testing code with better delays.
2025-01-08 Improved black line following, using the front middle colour sensor and also improving motors, reducing the bias with motor calibration.
2025-01-09 Fixed double green, improved green turns and green detection.
    [line.py, motors.py]
2025-01-09 Added Obstacle avoidance, laser sensor data, and touch sensor readings. Changed some function names.
    [colour.py, lasers.py, line.py, main.py, motors.py, touch.py]
2025-01-10 Improved obstacle avoidance and line following.
    [line.py]
2025-01-12 Added config variable to choose whether to use low transformed image or the normal image from the camera for HSV mask.
2025-01-14 fixing file / folder structure
    [camera.py, colour.py, config.py, evacuation_zone.py, gpio.py, laser_sensors.py, line.py, main.py]
2025-01-15 some more fixing but idk what i'm doing
    [colour.py, evacuation_zone.py, line.py, main.py]
2025-01-15 calibration now fixed, manual overwrite
    [colour.py]
2025-01-15 Fixed callibration in version 5_inverse of colour line following.
    [colour.py, main.py]
2025-02-17 removed virtual enviornment
    [pyvenv.cfg]
2025-02-17 new strucutre + PID
2025-02-18 tuned PID
    starting intersection handling
2025-02-18 updated intersection w/ PID correctly added?
    [line.py]
2025-02-19 some print fixes
2025-02-23 general green complete TODO: fix |- -| intersections, moving forwards until sensor sees black
    [line.py, main.py]
2025-02-26 speed increased - integral unbound to 10,000 - fixed intersection timings - added blue validation for claw - fixed |- -| alignment
    [config.py, evacuation_zone.py, line.py, motors.py, victims.py]
2025-02-28 TODO: - fix sharp turns - add gap detection
    [line.py, motors.py]
2025-03-02 gap_handling complete with sensor fusion -> camera now takes control
2025-03-02 gyroscope finished
2025-03-09 added LED to ramp
2025-03-09 Fixed led function calling names
    [led.py]
2025-03-09 Updated led function calling
2025-03-09 Added camera line following
    Camera line following function added.
    Updated PID function:
    1. Update gyro values in separate if statement
    2. Check for ramp, acute or evac exit for cam line following
    3. Else: turn off led and do normal line following
    Speeds and Kp values should be tuned further.
    Added exit camera line following. Should fine tune cam loop duration (in follow_line())
2025-03-10 Updating with technical documents
    Updating in prep for Japan and Singapore
    [2 x 18650 Battery Holder.stp, BNOO8X Frame.step, Back Base.step, Back Wheg - Back Wheg.step, Battery Base.step, Bottom Base.step, Claw - Drive Servo Frame.step, Claw - Rotating Frame.step]
2025-03-10 updated from kP based line follow -> kI based line follow, kP, kD as overshoot correction
    [camera.py, colour.py, colour_sensors.py, config.py, gyroscope.py, laser_sensors.py, line.py, listener.py]
2025-03-11 incoperated gyro into + T intserctions more PID tuning
2025-03-12 added all of intersection with gryo cleaned up PID
2025-03-15 calibration issues D:
2025-03-16 swapped back wheels
2025-03-17 fixing print statements and QOL
    [line.py]
2025-03-18 camera resolution and output fix - using raw modifier to determine sensor format and output - using main modifier to determine output to use
    [camera.py, config.py, evacuation_zone.py, line.py]
2025-03-18 minor fixes w/ desktop
    [evacuation_zone.py]
2025-03-19 victim detection testing - changed dead from RGB to HSV -> removed noise from background
    TODO: Find a way to sharpen ALL edges OR detect part of a contour that is circular
    [camera.py, config.py, evacuation_zone.py, victims.py]
2025-03-20 - victim count into file - fixed evacuation_speed - fixed print statements for debugging - fixed presence check - fixed grab sequence timings - added HSV filtering for triangles - added laser check f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
    [config.py, evacuation_zone.py, main.py, triangles.py, victims.py]
2025-03-21 Improved lien following for Frederick triple green, added Aidan's motor values, removed acute handling as that was confusing the fork situations
2025-03-21 fixed more evacuation_zone things - fixed finding evac lines - added debugging for presence check - changed triangle alignemnet sequence to allow for side-on approaches - fixed readibility for dead-v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
    [evacuation_zone.py, laser_sensors.py, motors.py, triangles.py, victims.py]
2025-03-21 Lining up to evac. Basic evac exit. Need to fix camera line following as it doesn't work (Need to re init camera settings).
    [config.py, evacuation_zone.py, gyroscope.py, line.py, motors.py, servo_timer.py]
2025-03-22 standardized print statements for initialisation
2025-03-25 green, obstacle, flow, fixes
    [camera.py, config.py, evacuation_zone.py, line.py, main.py, triangles.py, victims.py]
2025-03-25 more testing, added fake checking, evac error handling, multiple attempt catching
    [evacuation_zone.py, line.py, triangles.py, victims.py]
2025-03-26 inital idea, with a rocker switch program that runs on startup, allowing for starting and killing the competition_main.py which auto starts with line
2025-03-27 updated runner and competition_main with the correct code, removed stop from faulty logic in triangles.py
    [competition_main.py, runner.py, triangles.py]
2025-03-28 updated runner to stop on switch close
2025-03-28 day 1 calibration changes, progress 1
2025-03-28 day 1 calibration changes, progress 2
2025-03-29 calibrated presence check trying new exit values more red changes updated obstacle forced side or random
2025-03-30 tilted boards added
2025-04-04 emergency green fix for singapore
    [camera.py, line.py]
2025-04-13 testing camera_line_follow
2025-04-14 Testing camera linne following
2025-04-15 Completed green and black with new classes. Need to calibrate motors, calibrate green double turn times, do more running testing on green and black.
2025-04-24 Improved double green detection. Should first test silver dection. Then begin testing slanted, and speed bumps, incoporating the gyro.
2025-04-25 small adjustments to code.: green hold duration, double green turn duration.
    Further improvement to line following + green could be looking at hold green mechanism, and also not following the line if the contour is 180 or 0 degrees as in its touching the bottom for the reference point. Silver line could be viable with current setup as silver is slightly brighter in places compared to white however will probably still need colour sensors. General QoL imrovements could be threading to increase framerate although with X11 and without X11 doesn't rlly make a difference in performance. Could attempt threading with silver line ai detection if colour sensors do not work reliably.
    [camera.py, line.py]
2025-04-26 Fixed code structure. Beggining to add obstacle.
    [camera.py, colour_sensors.py, laser_sensors.py, line.py, listener.py, main.py, motors.py, robot.py]
2025-04-26 added obstacle v1 added gyroscope
2025-05-01 changing folder structure
    [2 x 18650 Battery Holder.stp, BNOO8X Frame.step, Back Base.step, Back Wheg - Back Wheg.step, Battery Base.step, Bottom Base.step, Claw - Drive Servo Frame.step, Claw - Rotating Frame.step]
2025-05-03 Added functions from clean code into line.py (robot state + new functions). Detecting Ramps and Tilts now works. Made code for display images in seperate thread to decrease proccessing times
2025-05-04 updated listener with button changes
2025-05-05 Fix variable reference in LineFollower and update avoid_obstacle function signature
    [line_follow.py]
2025-05-08 fixed the gap problem. need to ocnsider using robot state triggers/adding them back. could increase base speed after decrease servo voltage. Need to fix double green detection b y if len(green_contou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
    [gyroscope_sensor.py, line.py, listener.py]
2025-05-16 uncommented colour sensors, and gyro change follow line to follow function, add self. to image and display image, added lightest area for black masks, fixed timing with red and silver detetion for ca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
    [camera.py, line_follow.py, main.py, motors.py, robot.py, utilities.py]
2025-05-17 fixed line follow on tilted boards, fixed green on tilted boards except the angled double green that is recognized as uphill instead of tilted. obstacle doesnt work rn because rununtil does not exist.
    [laser_sensors.py, line_follow.py, utilities.py]
2025-05-17 fixed green turns. more testing with line follow to ensure it works on normal boards. (mostly a test with difficult tiles and tilted difficult tiles were done but could test a greater variety of tile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
    [line_follow.py, motors.py]
2025-05-20 Added ability to record. need to improve with proper timings, higher quality if possible, constantly recording and caputring images or just continuing capture during while loops or timed things in wh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
    [line_follow.py, main.py, utilities.py]
2025-05-20 calibrated motors for frederick
2025-05-21 added capture array into motors for continous videocapture, however may need to put video capture in seperate thread in order to keep delays accurate.
2025-05-21 fixed while loops in line follwo to make sure it is always capturing images
    [line_follow.py, motors.py]
2025-05-22 attempted to use the mask instead of contours for more points to work with when finding angles. one of the wheg tires fell off. need to improve lighting or add a mask for the corners of the screen
2025-05-22 updated EvacState updated locate function to correctly turn based on error switched from wall_follow to random for now added alignment and grab
    updated control loop for evac
    added spaces to claw class
    calibrated motors
    added testing folder
    [claw.py, evacuation_zone.py, motors.py]
2025-05-22 appended laser centering for evac added test.py
2025-05-25 added filtering based on x coodinate for live updated alignment to be fully laser based -> does not work for different sized victims added evacuation.base_speed added forced warmup and first inference
    [evacuation_zone.py]
2025-05-27 added dump and claw reading
2025-05-27 improved double green. improved obstacle. may need to increase speed and also add a stuck finder if gyro says low change in accelreation or waht not if stuck on a rare double speedbump + speedbump.
    [line_follow.py, motors.py]
2025-05-27 updated flow and display messages
2025-05-28 fixed claw.read() to take averages as well as account for variation in values
    [claw.py, laser_sensors.py, shared_imports.py]
2025-05-28 added left right close checks steer to motor
2025-05-29 added camera gracefully exiting updated approach_distances for live and dead increased live threshold fixed analyse logic to support live, dead, green, red based on victims saved and currently held u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
    [evacuation_camera.py, evacuation_zone.py, laser_sensors.py, main.py, robot.py]
2025-05-30 added more configs to evac_zone lowered live threshold added try except block directly to TPU updated red thresholds for lower saturation changed random speeds counting how many empty slots in the cl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
    [claw.py, evacuation_camera.py, evacuation_zone.py, laser_sensors.py]
2025-05-31 testing auto_calibrate for claw
2025-05-31 Calibrated old obstacle avoidance without testing downhill (kept new obstacle avoidance commented out)
    [line_follow.py, main.py]
2025-05-31 updated for obstacle avoidance for uphill. Removed motor.pause() for obstacle avoidance. Removed commented new (now previous) obstacle avoidance.
    [line_follow.py]
2025-05-31 added hough_circle +threshold dead added threshold dead tried try except block for AI updated empty_count calculation normalised debug lengths reduced maximum height on camera increased timing budget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
2025-05-31 added source validation for classic live and hough dead fixed cropping issues and coordinate system with last_x added back try except block for claw.read
    [claw.py, evacuation_zone.py]
2025-06-01 Added blue silver detection, fixed hsv mask testing with perspective transform, changed led on off to just on. Updated blue threshold. showing blue contours. updated double green turns. more forwards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
    [line_follow.py]
2025-06-01 fixed centre_x location logic
    [evacuation_zone.py]
2025-06-04 udpated reading from heavy sensors to be instantaneous: all sensors now read in a seperate thread in the background
2025-06-04 fixed all parallism for sensor readings required for evac_state
    [evacuation_camera.py, laser_sensors.py, listener.py, main.py, shared_imports.py]
2025-06-05 removed dependency on line follow speed in case we want to actually change line follow speed adn that ruins all other values.
2025-06-05 small gap handling improvements. need to work on uphill decrease kp, uphill and downhill needs more work and green should become hardcoded for uphill and downhill instead of auto turns because they s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
    [line_follow.py]
2025-06-06 Reduced the hieght at which camera reads when it follors line uphill to avoid following shadows
    [line_follow.py]
2025-06-06 Added timing for calcualte angle specifically as well. figured out that clacualte abgle was taking a long time. may consider ways to optimize camera capturing in seperate thread and optimizing calcul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
2025-06-07 improved uphill turns, need to fix downhill green with restriction speeds (need more testing for better values) or if that doesn't work then hardcoded green turns downhill can work.
    [line_follow.py]
2025-06-07 basic positioning done by lasers complete w/ lookup tables ~50ms
2025-06-08 fix down hill obstacle, especially into a double green. improved downhill turns such that it works if its a striaght into it (but wierd tiles like 270 degree sharp turns or the special spiderweb tile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
    [line_follow.py, main.py]
2025-06-20 downhill silver now working. however downhill is being ruined by tryign to get the s turn to work downhill so will need to use front camera and other things to get it to work.
2025-06-20 updated main.py to match the correct version
    [main.py]
2025-06-28 Create Bill of Materials.pdf
2025-06-29 fixed stuff for final merge
    [evacuation_zone.py, main.py, motors.py, robot.py, shared_imports.py]
2025-06-29 added i2c baudrate setup
2025-07-01 ignore all temp frames
2025-07-02 fixes to laser, blcoking
    [evacuation_zone.py, laser_sensors.py, main.py, motors.py, utilities.py]
2025-07-02 Added Aidan's claw settings
2025-07-02 added finding exit fixed show() calls in line follow
    [evacuation_zone.py, line_follow.py]
2025-07-03 updated evac, silver detetion and coloru sensor calcibration and exit evac
2025-07-04 cleaned up silver detection, need more testing fake silvers (uphills and speedbumps). Could attempt to use gyro later
2025-07-04 Added stuck detection (needs testing)
    [line_follow.py]
2025-07-05 updated routing method increased tolerance on live victims updated wall_follow to use constants added comments to wall_follow updated evac_camera added ADS testing
    [claw.py, evacuation_camera.py, evacuation_zone.py, laser_sensors.py]
2025-07-05 added alt channels to colour sensors
2025-07-05 fixed silver, still need to look into turns downhill with speedbumpl
    [camera.py, colour_sensors.py, evacuation_camera.py, line_follow.py, listener.py, main.py, shared_imports.py, silver_sensor.py]
2025-07-05 fixed stuck detection and imporved silver detection for reflective silver evac line entries.
    [line_follow.py]
2025-07-06 added new calibration
2025-07-07 added random seeding added extra debug info fixed live victim identification updated random spinning so it's not that random updated vairable names
    [main.py, optimized_evacuation.py, shared_imports.py]
2025-07-07 fixed silver line detection added exit added triangles added wall follow added grabbing direction fail thing
    [line_follow.py, main.py, optimized_evacuation.py]
2025-07-08 attemped fix at exit logic for triangles in route
    [optimized_evacuation.py]
2025-07-08 silver updated with robot_state variable for easy switching, updated and fixed gap by decreasing camera back sight, and updated amount of forwards
    [camera.py, line_follow.py]
2025-07-09 before attempting other silver fixes e.g. zac's strat or ai.
    [line_follow.py]
2025-07-10 fixed pixel areas and other pixel related changes when halving the resolution (still need testing)
    [line_follow.py]
2025-07-10 small fixes, removed global, better imports, shorter if statements.
    [line_follow.py, optimized_evacuation.py, shared_imports.py, utilities.py]
2025-07-11 added settings for live victims removed erode updated evac camera
2025-07-11 added captre script into tests in 0_international/ in order to have updated camera settings befure capputring images for silver. updated closing camera etc in main and caputre script
2025-07-11 Add quantized silver detector model
    Added the quantized PyTorch model for silver line detection on Raspberry Pi 4. This model will be used for inference in the silver line detection pipeline.
2025-07-14 Updated comments and oled, along with more checks for silver detection, Still need to test the oled display text to make sure it looks good (nothing goes over the screen size). Also need to test the 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
    [line.py, line_follower.py, oled_display.py, robot_state.py]
2025-07-16 convex hull
2025-07-16 added autostart script added saving video screen to main updated sensor pins
2025-09-26 realised that the issue with green is the led's so if it conitnues we can debug that next time
2025-09-27 hopefully fixed seeing green late but also could just be because of changing the wheels and making them less grippy at the back. may go back to just less grippy overall, so it has a consistent rotati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
    [line_follower.py]
2025-10-04 git ignore new saved frames in sessions.
    main: added new save frame stuff, removed old video proccessing
    line_follower:
    increase pid, decrease min black area, added seeperate turn color customization variable, added new black mask setup specific to the led placements and the dark corner shadows, fixed some variable if statmeents and naming, added a debug clear while the program starts running t avoid the spam at the start of hte run, updated green turn to better match decreased friction on tires. decrease check size of blakck for green turns, green mask ranges and erode cahnges, removed printing green contour area, remved unnecessary uncommented code for gaps, ,extra erode for gaps, increas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
    [camera.py, line.py, line_follower.py, main.py, shared_imports.py, utilities.py]
2025-10-09 fixed evac directions for turning, changed speeds and changed to blind dead victim grabbing in case the ir sensors fail for dead victims. also updated obstacle and functions that rely on colour value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
    [camera.py, claw.py, evacuation_camera.py, laser_sensors.py, line.py, line_follower.py, main.py, optimized_evacuation.py]
